nerdprojects/line-robot/README.md

# Roboterauto
Ein einfacher Roboter, welcher einer Linie nachfahren kann.
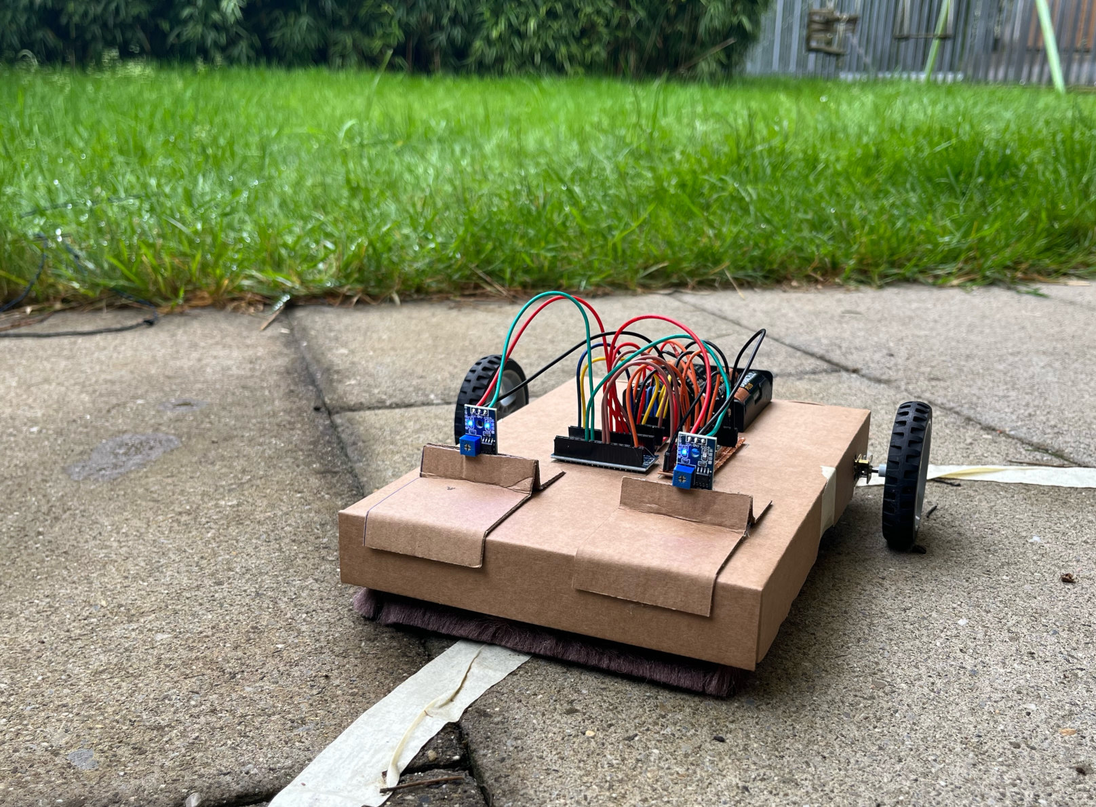
[picture p1: robot.jpg]


## Anleitung
Eine kurze Anleitung zum Roboter findet ihr unter [manual.pdf](https://raw.githubusercontent.com/nerdprojects/line-robot/main/manual.pdf).

## Software
Den Programmcode findet ihr unter [software/software.ino](https://github.com/nerdprojects/line-robot/blob/main/software/software.ino).
Wenn ihr selber die Software anpassen möchtet, könnt ihr die Arduino IDE verwenden. Mehr Infos dazu findet ihr unter: [https://www.arduino.cc/en/software](https://www.arduino.cc/en/software)
